AntoineLeCalvez/Un-drone-au-bout-des-doigts/README.md

# Un-drone-au-bout-des-doigts
This 8-month electronics team (9 teammates) project was part of the 4th year (Master 1) at INSA Rennes. We developed a drone controlled by hand gestures.
