AntoineLeCalvez/Un-drone-au-bout-des-doigts/Specifications_powerpoint.pdf

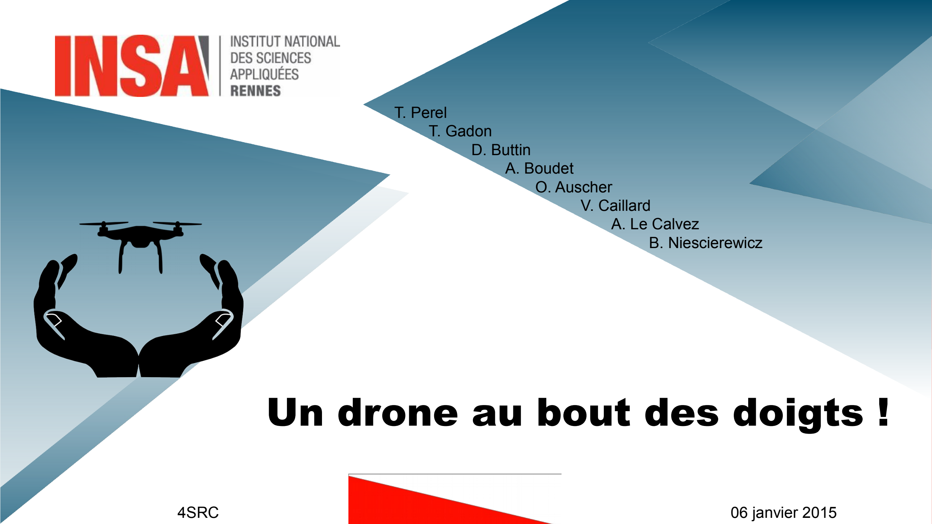
[picture p1: page 1]

# Un drone au bout des doigts !

T. Perel
T. Gadon
D. Buttin
A. Boudet
O. Auscher
V. Caillard
A. Le Calvez
B. Niescierewicz
4SRC | 06 janvier 2015

2

## Introduction

❖ Projet pluridisciplinaire, 4e année SRC : piloter un drone avec la main
- 1er semestre : élaboration du cahier des charges
- 2e semestre : réalisation du prototype

❖ Intérêts du projet :
- asseoir les compétences théoriques et pratiques vues en cours
- auto-formation sur des notions non abordées
- avant-goût de notre futur métier d’ingénieur :
■ travail en équipe
■ sujet technique et innovant
■ de la conception à la réalisation
■ respect des contraintes budgétaires et de temps

3

1. Présentation du projet et état de l’art
2. Reconnaissance des gestes
3. Drone
1. Réception des données
2. Pilotage
4. Premiers tests
5. Gestion du projet
1. Diagramme de Gantt
2. Budget
6. Démonstration

## Présentation du plan

## 4 Présentation du projet

❖ Idée plutôt que besoin

❖ Applications diverses

- Civiles (loisir, reconnaissance)
- Militaires (reconnaissance)

❖ Fabrication d’un drone mais définition d’un nouveau mode de pilotage

## 5 État de l’art

❖ Projets existants :
- Multitude de projets
universitaires

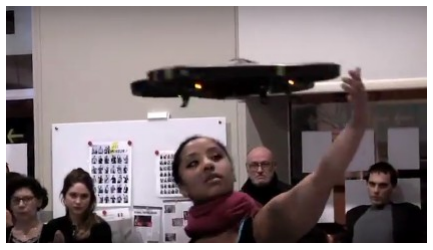
[picture p2: figure]

Projet “Danse avec les drones”

❖ Problème : bluetooth (faible portée)

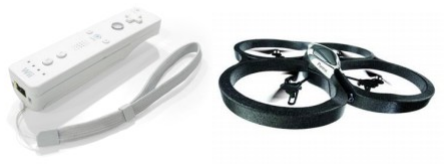
[picture p3: figure]

- Reconnaissance d’image (latence éventuelle)

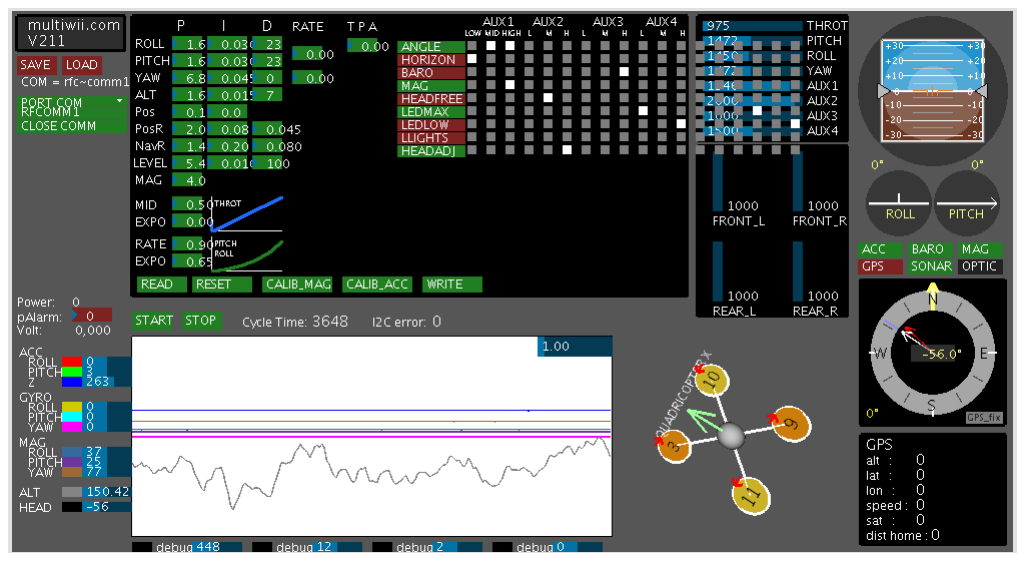
[picture p4: figure]

❖ MultiWii : code open-source modifiable
- Dispose d’une interface de réglage très utile pour tester notre système

## 6 Reconnaissance des gestes

Solution principale (2 mains)

2 gyroscopes
❖ Gaz
❖ Roll & Pitch

Solution alternative (1 main)

1 accéléromètre
❖ Système de visée
❖ Gaz et Roll: mouvements dans un plan ❖ Pitch: fléchissement du bras

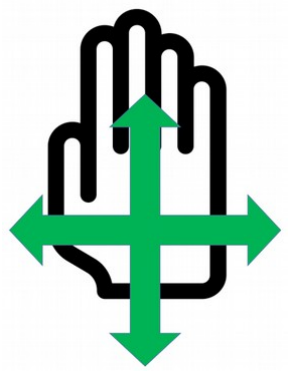
[picture p5: figure]

Mode Headless

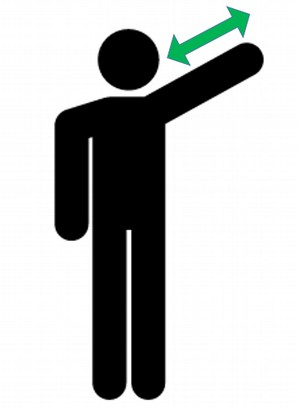
[picture p6: figure]
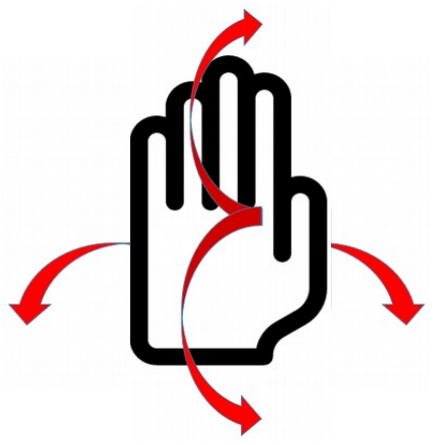
[picture p7: figure]

## 7 Reconnaissance des gestes

❖ Utilisation du MPU-6050

Contient accéléromètre + gyroscope | Bibliothèques déjà existantes

Grande précision des données (conversion
analogique/digitale sur 16 bits)

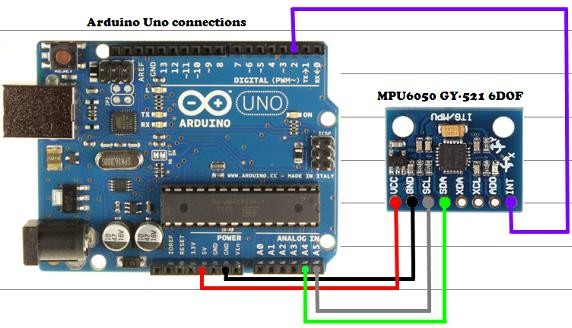
[picture p8: figure]

Connexion Arduino - MPU6050

Adapté à l’environnement Arduino

## 8 Drone

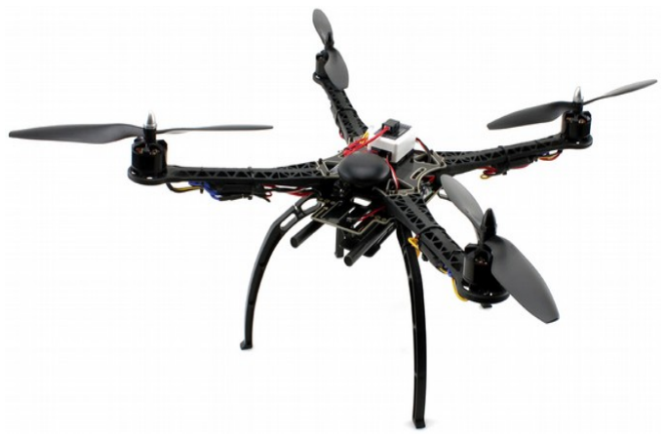
[picture p9: figure]

❖ Critères de choix généraux :

- Taille :

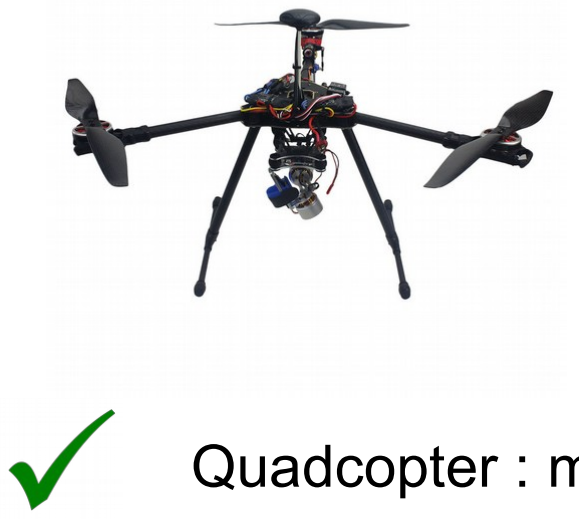
[picture p10: figure]
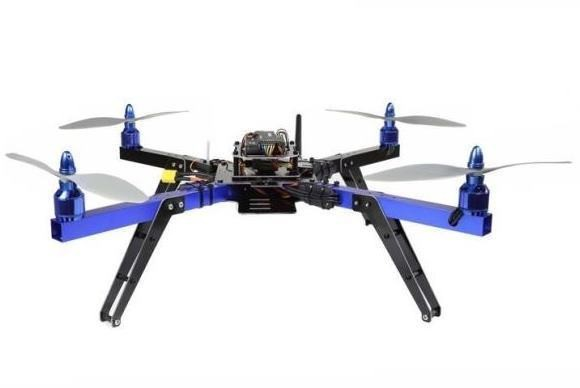
[picture p11: figure]
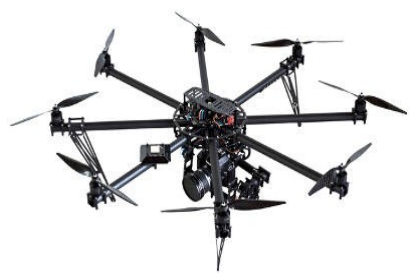
[picture p12: figure]

Quadcopter : meilleur compromis prix/communauté

Taille moyenne : meilleur compromis prix/intégration

- Type :

## Drone

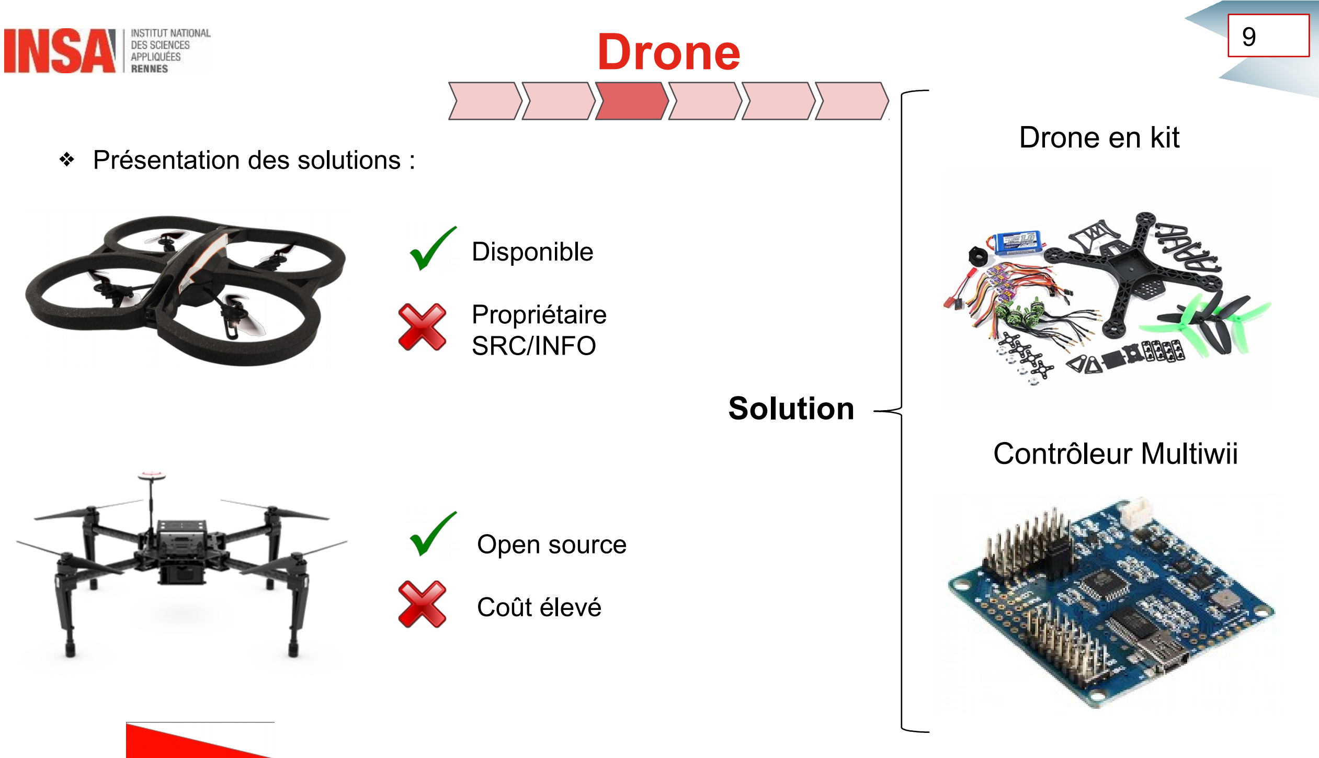
[picture p13: page 9]

9

Disponible

Propriétaire
SRC/INFO

Open source

Coût élevé

Drone en kit

Contrôleur Multiwii

Solution

❖ Présentation des solutions :

## 10 Réception des données

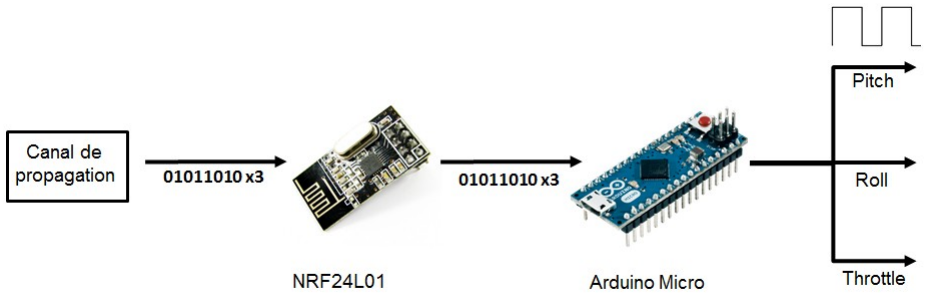
[picture p14: figure]

## 11 Pilotage

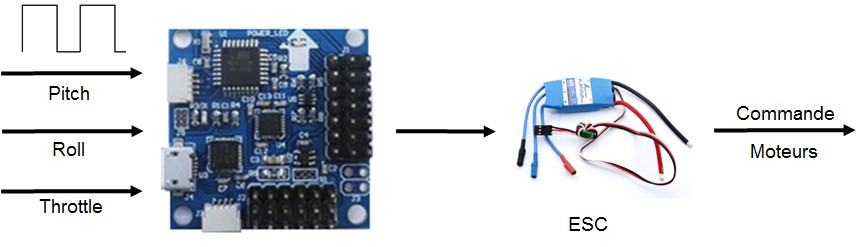
[picture p15: figure]

## 12 Premiers tests

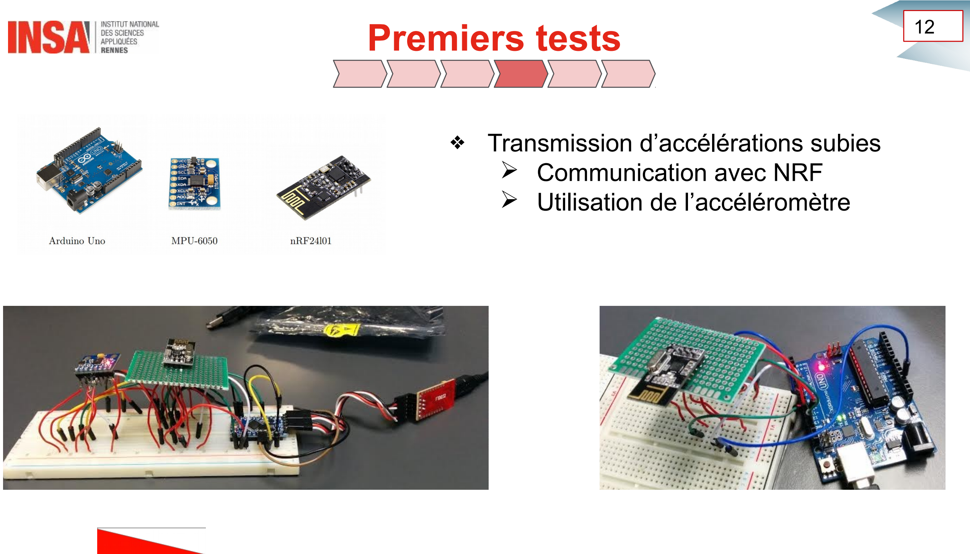
[picture p16: page 12]

❖ Transmission d’accélérations subies
- Communication avec NRF
- Utilisation de l’accéléromètre

## 13 Premiers tests

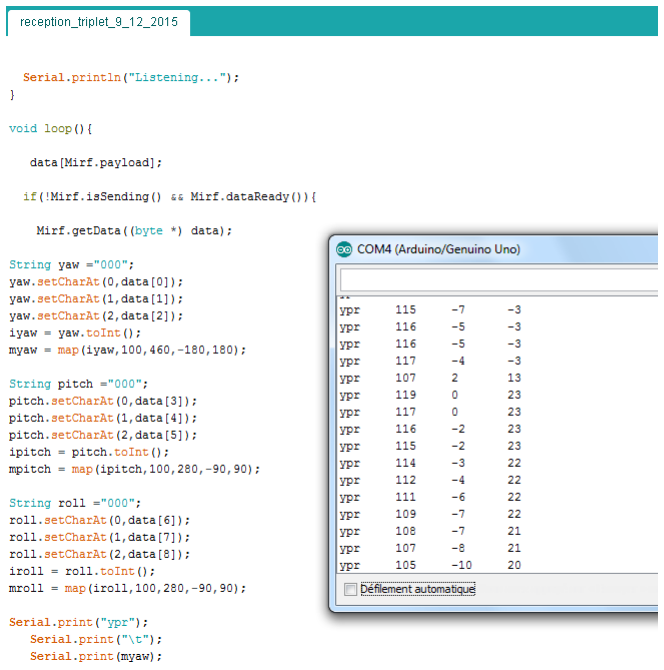
[picture p17: figure]

Extrait de code récepteur et affichage des données

❖ Utilisation de bibliothèques associées aux composants

❖ Latence raisonnable pour notre application

❖ Portée suffisante

## 14 Gestion du projet

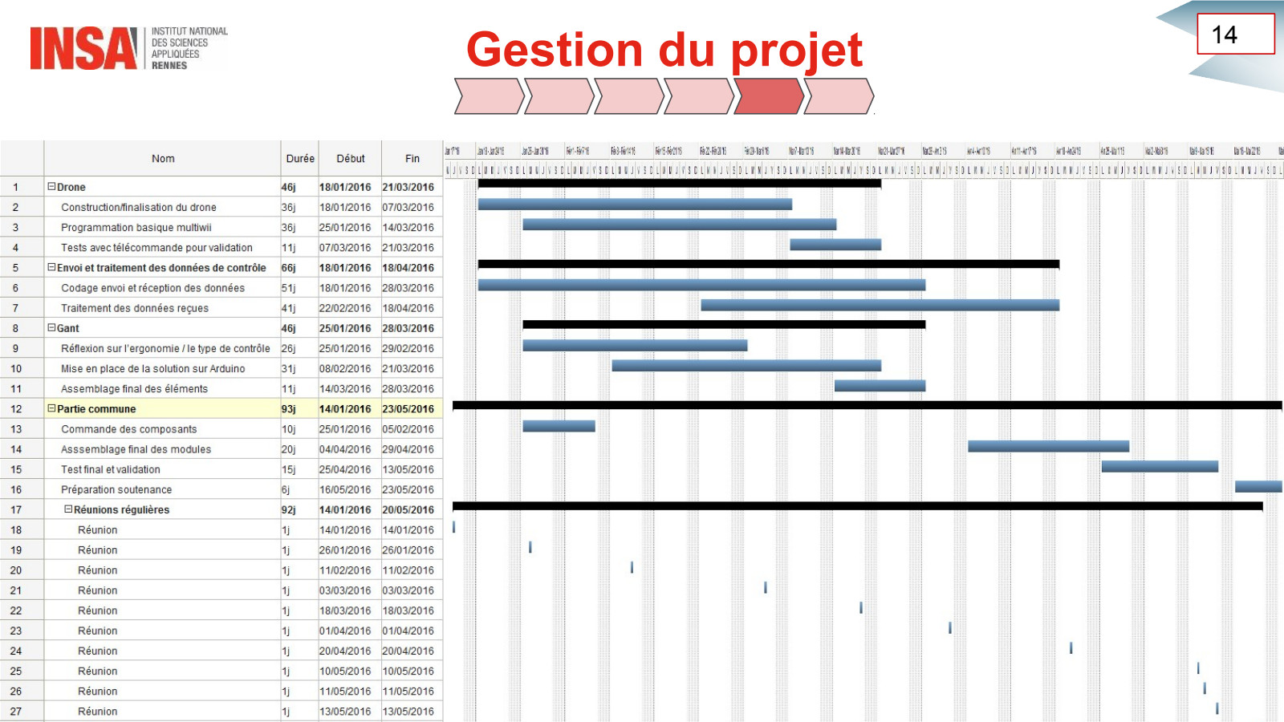
[picture p18: page 14]

Gestion du projet | 15

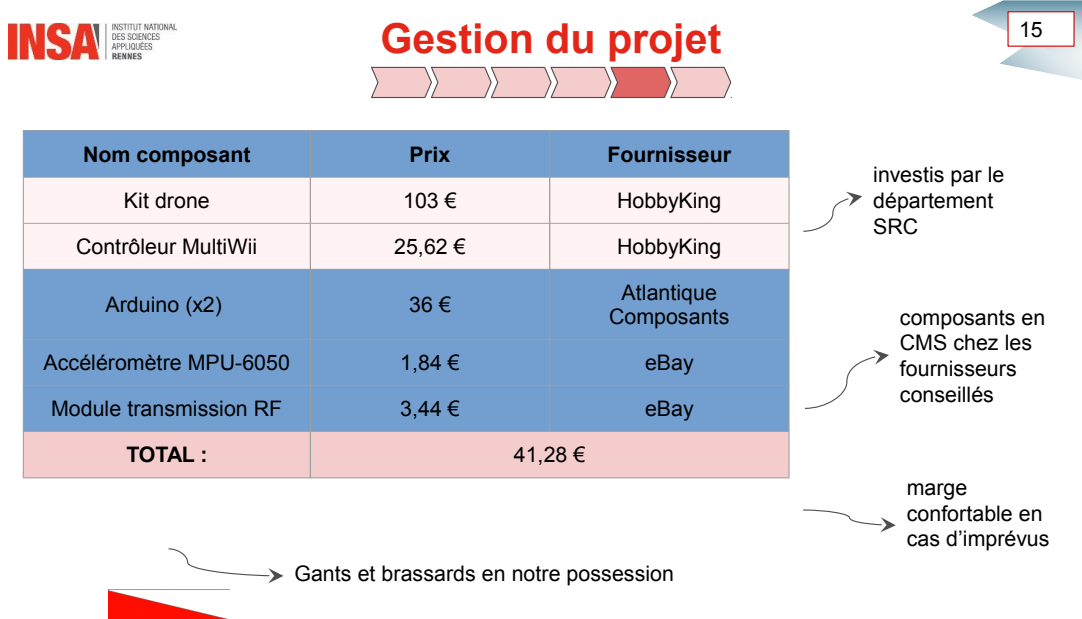
[picture p19: page 15]
marge confortable en cas d’imprévus

Nom composant | Prix | Fournisseur

investis par le
département
SRC

Kit drone | 103 € | HobbyKing

Contrôleur MultiWii | 25,62 € | HobbyKing

Arduino (x2) | 36 € | Atlantique Composants

composants en
CMS chez les
fournisseurs
conseillés

Accéléromètre MPU-6050 | 1,84 € | eBay

Module transmission RF | 3,44 € | eBay

TOTAL : | 41,28 €

Gants et brassards en notre possession

## 16 Démonstration

❖ Environnement intérieur mais haut de plafond (Halle INSA)

❖ 1 pilote volontaire + 1 assistant
- Assistant : mise sous tension du drone
- Pilote : fait décoller le drone, effectue quelques mouvements et le repose sur le sol

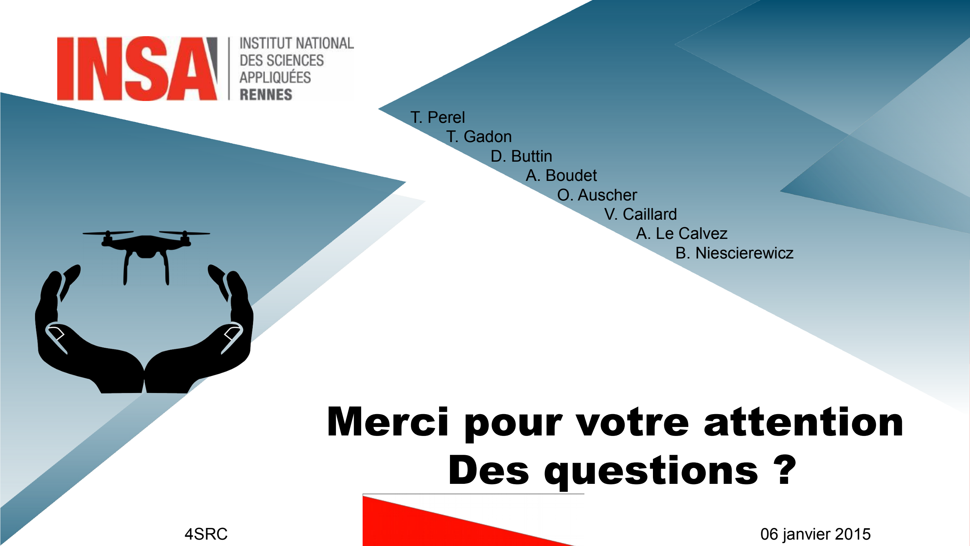
[picture p20: page 17]

# Merci pour votre attention Des questions ?

T. Perel
T. Gadon
D. Buttin
A. Boudet
O. Auscher
V. Caillard
A. Le Calvez
B. Niescierewicz
4SRC | 06 janvier 2015
