AntoineLeCalvez/Un-drone-au-bout-des-doigts/Final_Powerpoint.pdf

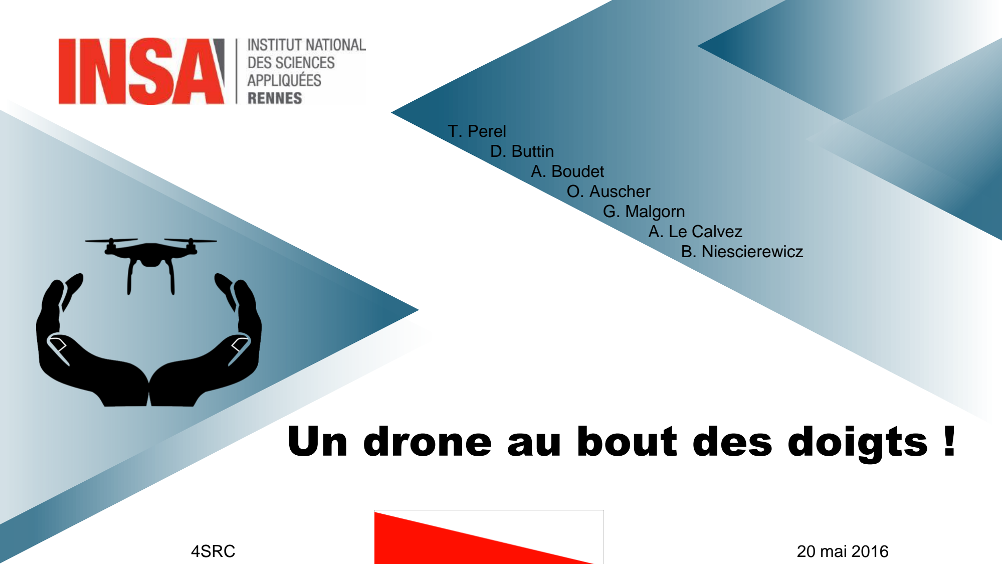
[picture p53: figure]
Un drone au bout des doigts !; 4SRC; 20 mai 2016; T. Perel D. Buttin A. Boudet O. Auscher G. Malgorn A. Le Calvez B. Niescierewicz

# Introduction

★ Projet pluridisciplinaire, 4e année SRC : piloter un drone avec la main
- 1er semestre : élaboration du cahier des charges
- 2e semestre : réalisation du prototype

★ Intérêts du projet :
- asseoir les compétences théoriques et pratiques vues en cours
- auto-formation sur des notions non abordées
- avant-goût de notre futur métier d’ingénieur :
■ travail en équipe
■ sujet technique et innovant
■ de la conception à la réalisation
■ respect des contraintes budgétaires et de temps

I. Présentation du projet

II. Mains

A. Reconnaissance des gestes
B. Prototype

III. Drone

A. Principe général
B. Prototype du récepteur

IV. Bilan

V. Démonstration

# Présentation du plan

Présentation du concept

# Présentation du projet

★ Un nouveau concept

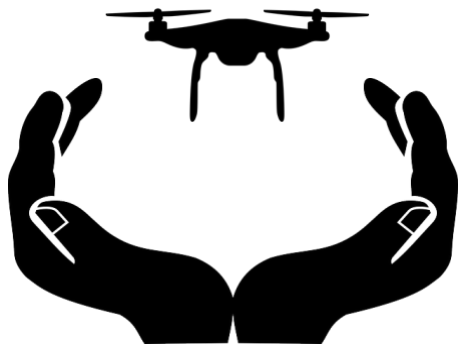
[picture p54: figure]

★ Piloter un drone avec les mains

★ Ludique et intuitif

★ Accessible à un plus grand nombre

Etat de l’art

# Présentation du projet

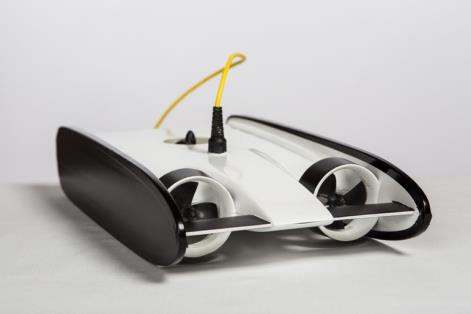
[picture p55: figure]

★ Drone utilisé dans diverses applications

- Militaires
- Civiles

★ Création d’un nouveau système de pilotage

- Système comparable à une télécommande

Etat de l’art

# Présentation du projet

★ Projets universitaires

- Danse avec les drones

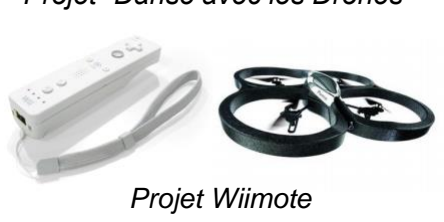
[picture p56: figure]
Projet Wiimote

- Télécommande de Wii (Wiimote)

★ MultiWii

- Contrôle de multicoptères
- Code open source modifiable
- Interface de réglage intuitive

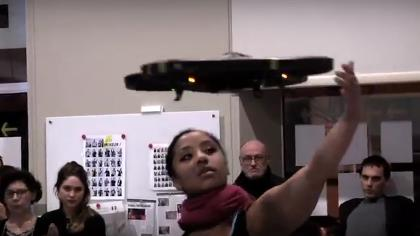
[picture p57: figure]

Projet “Danse avec les Drones”

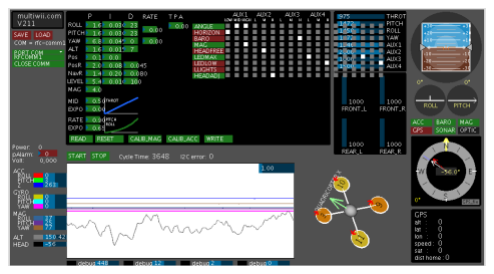
[picture p58: figure]

Multiwii

Présentation du projet | 7

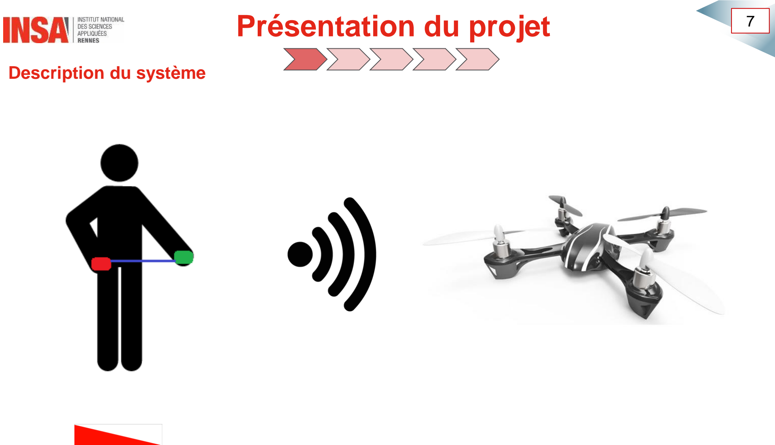
[picture p59: page 7]

Description du système

Principe et objectifs

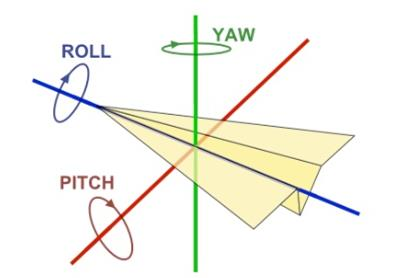
[picture p60: figure]

3 informations à acquérir et à transmettre au drone :

★ Throttle - Gaz = Puissance des moteurs

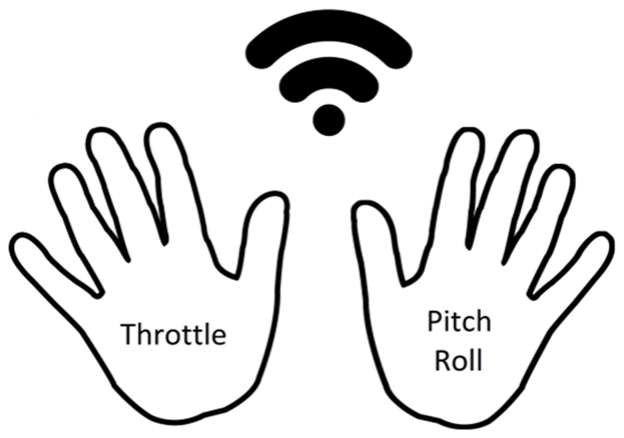
[picture p61: figure]

★ Pitch - Tangage = Orientation avant/arrière

★ Roll - Roulis = Orientation gauche/droite

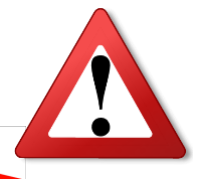
[picture p62: figure]

Le Yaw (Lacet) n’est pas transmis : Mode Headless

Mains | 8

Solution technique :

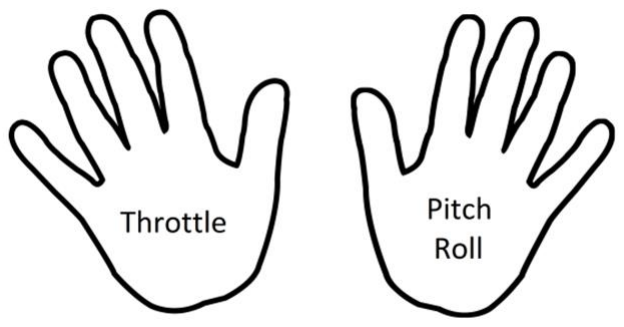
[picture p63: figure]

★ 2 capteurs de type gyroscope Récupération des angles

★ 2 microcontrôleurs
Traitement des données

# Mains

Acquisition des données

3 angles = 3 informations

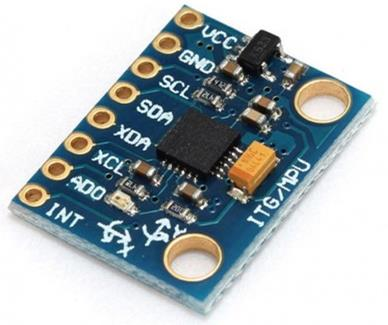
[picture p64: figure]

Solution technique :

★ 2 MPU6050

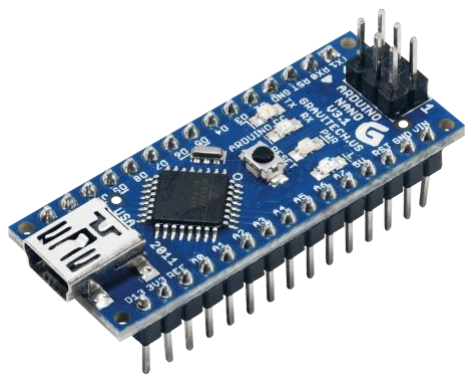
[picture p65: figure]

★ 2 Arduinos nano

# Mains

Acquisition des données

3 angles = 3 informations

3 angles = 3 informations | Solution technique :

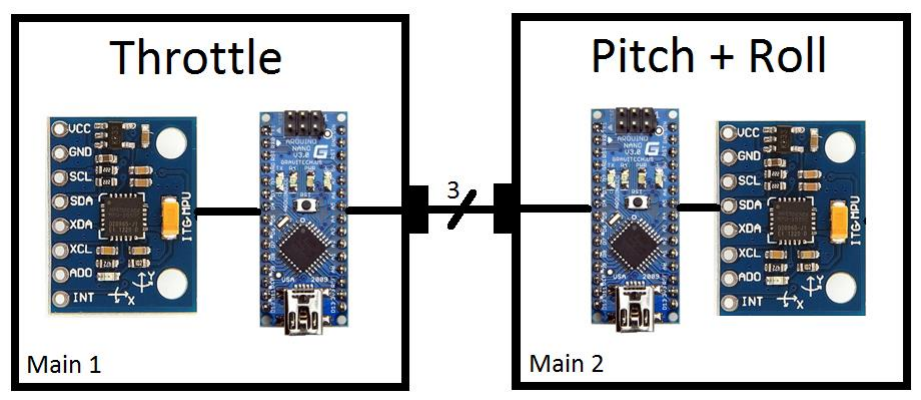
[picture p66: figure]
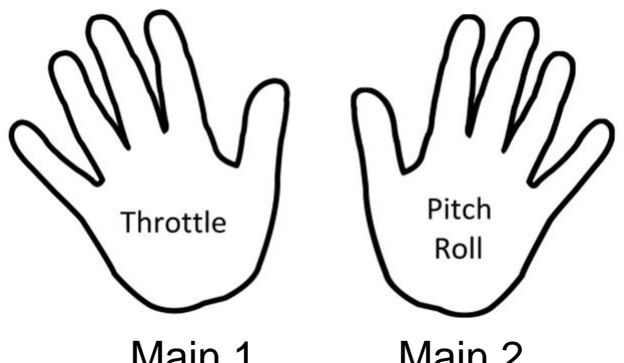
[picture p67: figure]

Main 1 | Main 2

Récupération du triplet sur le même Arduino ?

Acquisition des données

Mains | 11

Acquisition des données

Le throttle module le duty cycle d’un signal PWM

L’Arduino de la main 2
récupère le triplet

La main 1 récupère
le throttle

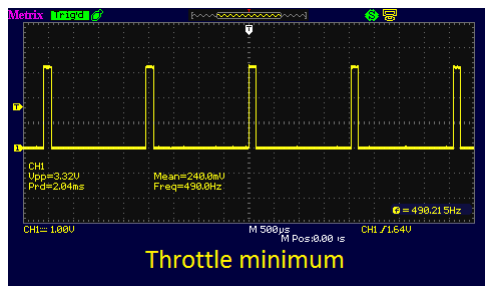
[picture p68: figure]
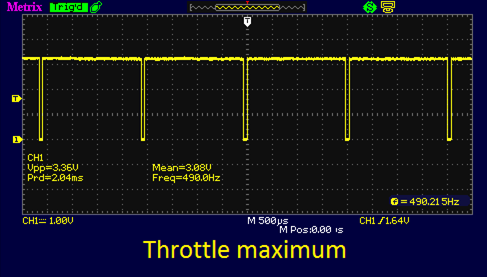
[picture p69: figure]

Transmission du triplet ?

Mains | 12

Transmission des données

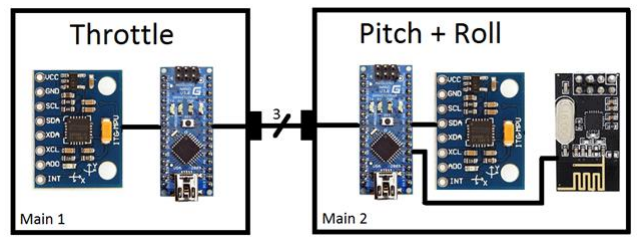
[picture p70: figure]
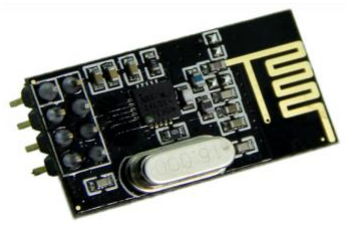
[picture p71: figure]

Module d’émission
NRF24L01 2.4GHz

Acquisition des données

Transmission des données

Mains | 13

Prototype

Étapes :

★ Tests sur breadboards

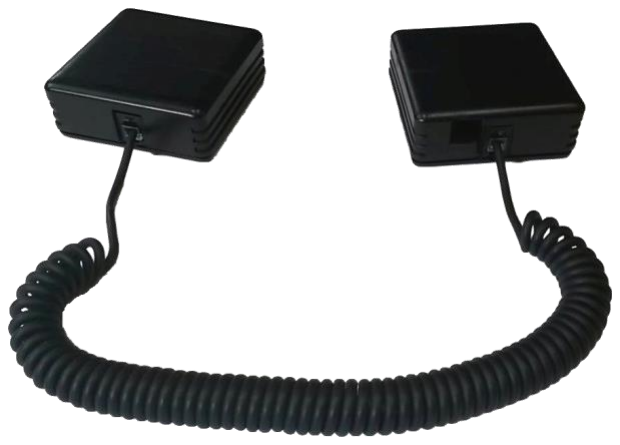
[picture p72: figure]

★ Conception et réalisation des circuits imprimés

★ Tests finaux

★ Intégration des cartes dans les boîtiers

★ Liaison entre les boîtiers

Mains | 14

Principe général

# Drone

★ Drone open source et facilement configurable

★ Coût raisonnable

★ Réutilisable pour les années suivantes

★ Environnement de programmation Arduino

★ Interface graphique facile d’utilisation

★ Capteurs (magnétomètre, baromètre…)

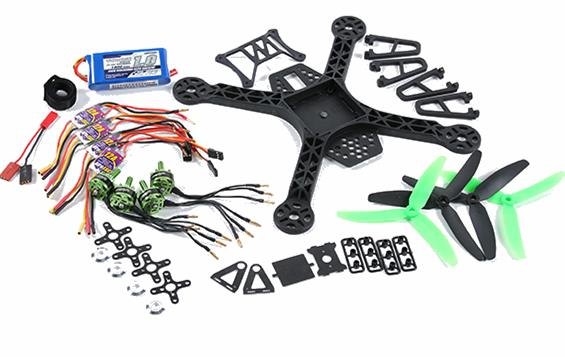
[picture p73: figure]

Drone en kit

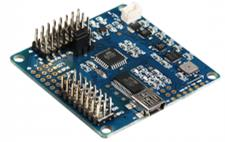
[picture p74: figure]

Contrôleur Multiwii

Réglages du quadcopter

# Drone

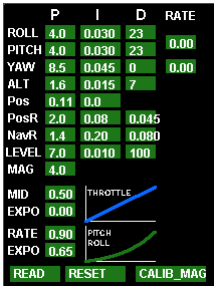
[picture p75: figure]

★ Réglages des PID

★ Choix du mode de vol

★ Intégration de fonctions complémentaires

Prototype du récepteur

# Drone

Signal CPPM

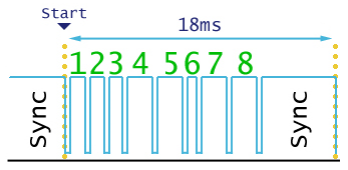
[picture p76: figure]

★ Signal attendu par le contrôleur de vol

★ Conversion des angles des mains en impulsions de durée variable

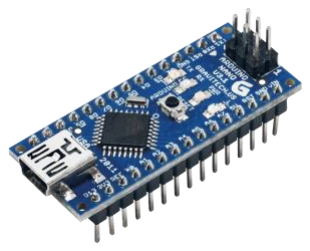
[picture p77: figure]
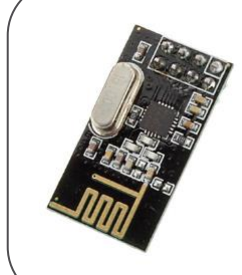
[picture p78: figure]

Commande des moteurs progressive Pilotage du drone précis

Bilan technique

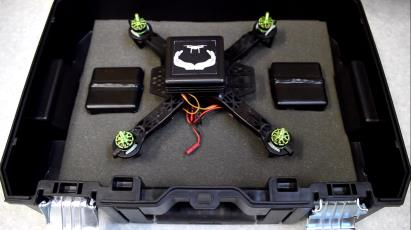
[picture p79: figure]

Améliorations possibles

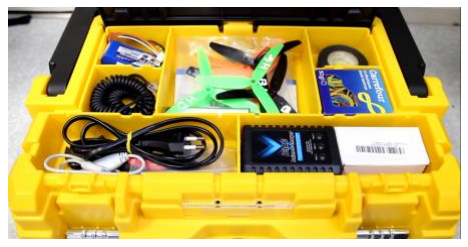
[picture p80: figure]

★ Prototype fonctionnel

★ Produit fini

Software | Hardware
★ Amélioration de la latence ★ Ajout d’options ★ Ajout de fonctions de sécurité | ★ Ajout d’un sonar ★ Déplacement de la diode d’amorçage ★ Miniaturisation des cartes
Bilan | 18

Gestion du projet

Organisation

★ Globalement bien réparties

★ Une tâche par binôme

★ Aide entre binômes si besoin

Répartition des tâches

★ Google Drive : plateforme de partage, accès à tous les documents, à tout moment

★ Réunions régulières : au moins une fois par semaine

★ Bonne communication et bonne entente au sein du groupe

Bilan | 19

Nom composant | Fournisseur | Prix
Kit drone + Contrôleur MultiWii | HobbyKing | 170 €
Module transmission RF + Arduino (x2) | Bangood | 10,44 €
Capteur MPU | Amazon | 9,21 €
Sonar + 3e Arduino | Bangood | 4,45 €
Batterie + connecteurs + hélices de rechange | Bangood | 14,88 €
Boitiers de protection + Connecteurs RJ9 | Atlantique Composants | 11,83 €
Fournitures diverses + frais de port | | 8,57 €
TOTAL : | 59 €

Pris en charge par le
département SRC

Contrainte budgétaire
respectée

Fournisseurs hors liste :
composants moins chers
et prêts à l’emploi

Montant prévisionnel : 37,84 € + options sécurité
+ composants de rechange
+ 2e Arduino + boitiers

# Bilan

Budget

★ Etat d’avancement :

- Dans les temps, pas de retard
- Gantt mis à jour régulièrement

★ Changement par rapport au Gantt prévisionnel :

- Absence de Gilles Picoult, 2 semaines en mars : routage des cartes avancé
- Soutenance avancée de cinq jours : prévenus à l’avance, pas d’impact majeur
- Premier vol du drone : 23 mars, trois semaines avant la date prévue

Contrainte temporelle respectée

# Bilan

Diagramme de Gantt

★ Plusieurs critères de protection :

- Nouveauté
- Non-évidence, inventivité
- Application industrielle

Rencontre avec Mr GUILHAIRE, Ouest Valorisation

# Bilan

Brevetabilité

★ Notre projet :

- Système comparable : smartphone
- Différences :
■ Usage des deux mains
■ Throttle sous forme d’angle

★ Conclusion de l’entretien :

- Non validation des critères de nouveauté et d’inventivité
- Regard extérieur et qualifié : apporte une finalité au projet

Démonstration | 23

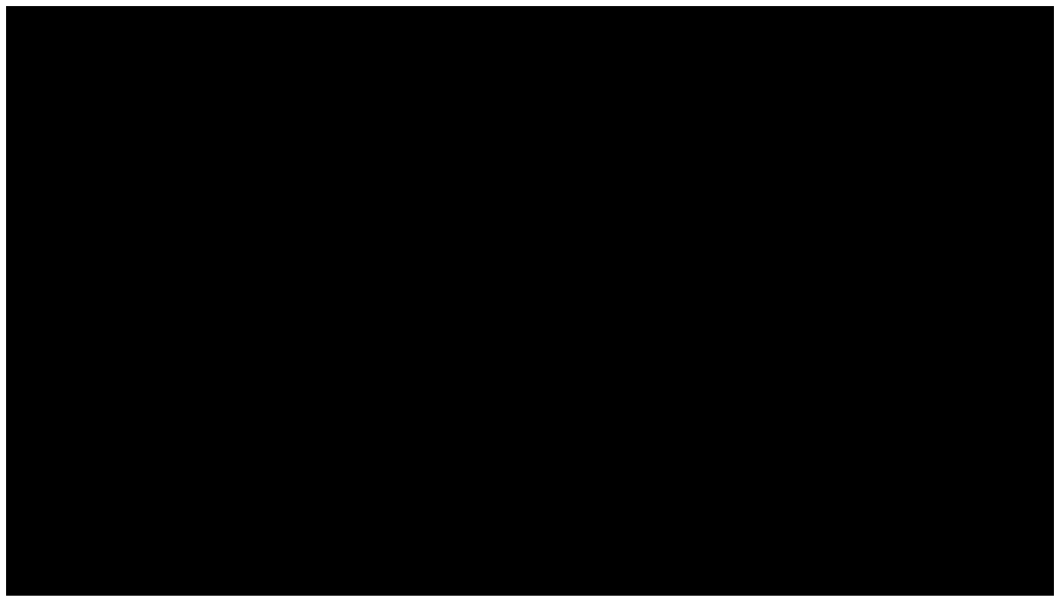
[picture p81: figure]

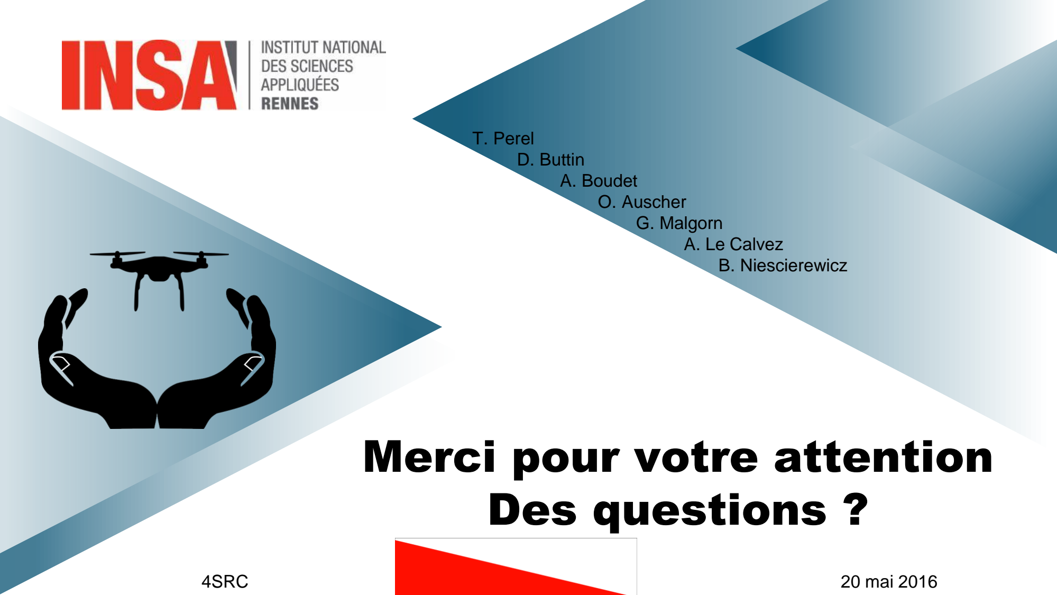
[picture p82: figure]
Merci pour votre attention; Des questions ?; 4SRC; 20 mai 2016; T. Perel D. Buttin A. Boudet O. Auscher G. Malgorn A. Le Calvez B. Niescierewicz
