AntoineLeCalvez/Un-drone-au-bout-des-doigts/Poster.pdf

# Un drone au bout des doigts

### Projet électronique 2015-2016

A. Boudet, D. Buttin, A. Le Calvez, T. Perel, O. Auscher
B. Niescierewicz, G. Malgorn, V. Caillard, T. Gadon

Département
Systèmes
et Réseaux

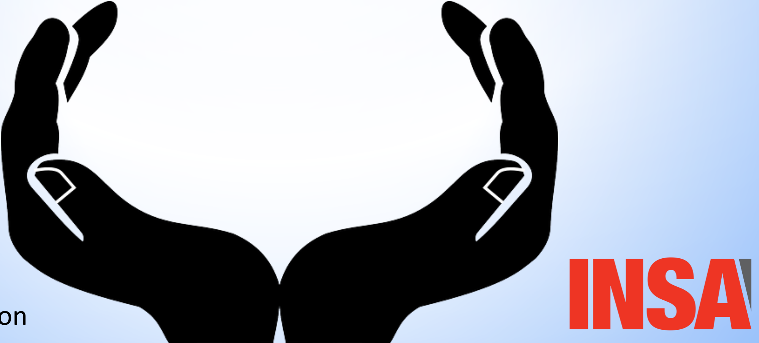
[picture p83: figure]

de Communication

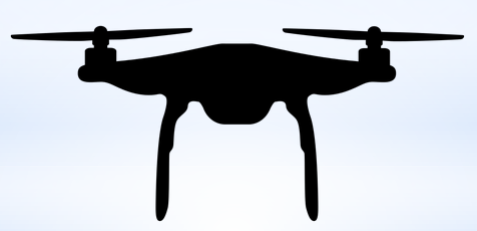
[picture p84: figure]

## Transformez vos mains en une véritable télécommande de drone !

### Innovation Un nouveau mode de pilotage de drone

### Ergonomie Une prise en main rapide intuitive et sécurisée

### Distribution Un système entièrement open-source

Conseils et réalisations techniques : Gilles Picoult
