AntoineLeCalvez/Un-drone-au-bout-des-doigts/(list of files, drawings)

Other design files:
main_1.pcb
main_2.pcb
recepteur.pcb
